mbilucaglia/ESB/Design files/usb_pcb/schematic_images/dpdt_switch.png

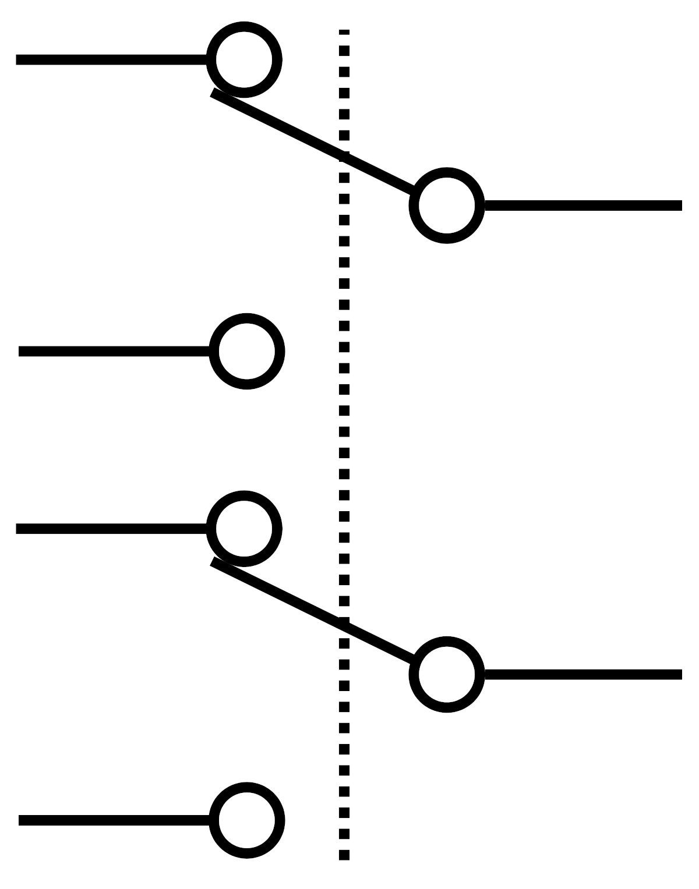
Design files/usb_pcb/schematic_images/dpdt_switch.png
