mbilucaglia/ESB/Design files/usb_pcb/schematic_images/led.png

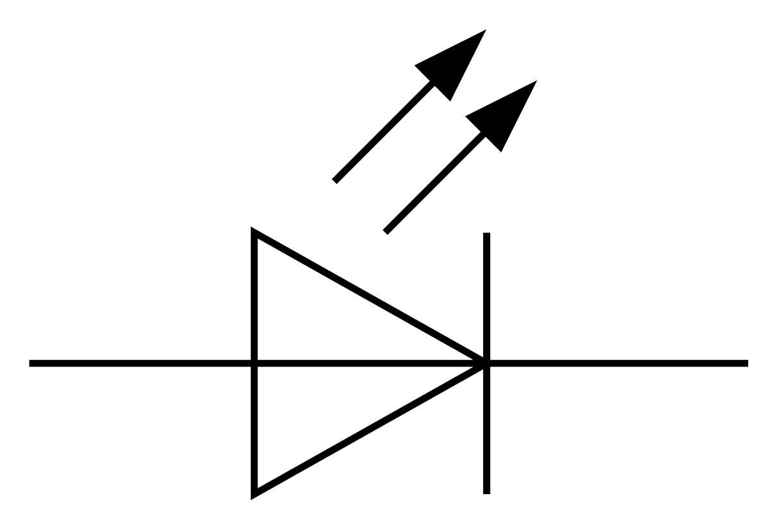
Design files/usb_pcb/schematic_images/led.png
