mbilucaglia/ESB/Design files/usb_pcb/schematic_images/spst_switch.png

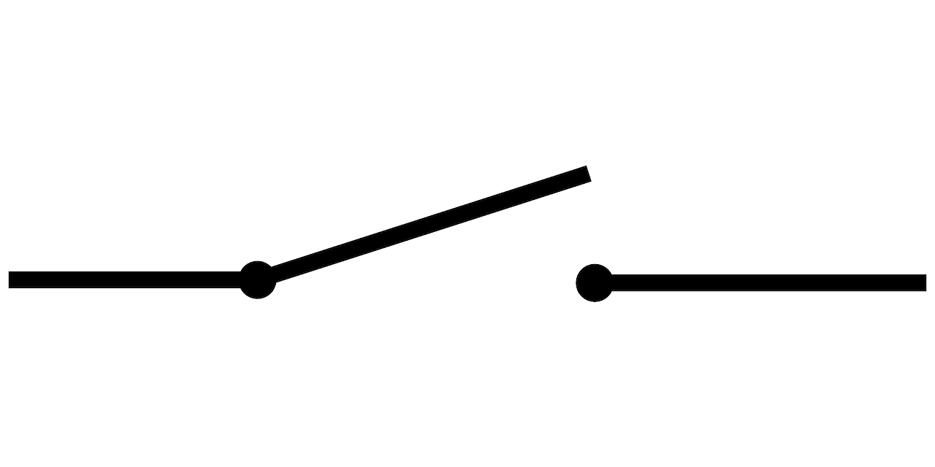
Design files/usb_pcb/schematic_images/spst_switch.png
