mbilucaglia/ESB/Bill of materials/BillOfMaterials.xlsx

Schematic ID | Designator | Component | # | Cost per unit-currency | Total cost-currency | Source of materials | Part ID (Mouser) | Total quantity | Total cost
C1 | Capacitor | 10nF 10%, 25V | 1 | 0.49 € | 0.49 € | Mouser Electronics | 80-C321C103K3G5TA | 44 | 35.828
C2, C6,C8 | Capacitor | 1uF 10%, 50V | 3 | 0.41 € | 1.22 € | Mouser Electronics | 810-FG14X7R1H105KRT6
C3 | Capacitor | 1nF 10%, 25V | 1 | 0.37 € | 0.37 € | Mouser Electronics | 80-C320C102K3G5TA
C4, C5, C7 | Capacitor | 100nF 10%, 25V | 3 | 0.25 € | 0.76 € | Mouser Electronics | 810-FA18X8R1E10400
D1 | Diode | 1N4007 | 1 | 0.16 € | 0.16 € | Mouser Electronics | 625-1N4007-E3/54
R1 | Resistor | R680 1% | 1 | 0.15 € | 0.15 € | Mouser Electronics | 594-5053HD680R0F
R2 | Resistor | R270 1% | 1 | 0.13 € | 0.13 € | Mouser Electronics | 594-5043ED270R0F
R3, R11, R12 | Resistor | R33k 1% | 3 | 0.13 € | 0.38 € | Mouser Electronics | 594-5043ED33K00F
R4 | Resistor | R10M 1% | 1 | 0.09 € | 0.09 € | Mouser Electronics | 594-5063JD10M00FT
R5 | Resistor | R10 1% | 1 | 0.11 € | 0.11 € | Mouser Electronics | 594-5063JD10R00F
R7 | Resistor | R18k 1% | 1 | 0.13 € | 0.13 € | Mouser Electronics | 594-5043ED18K00F
R8 | Resistor | R100k 1% | 1 | 0.10 € | 0.10 € | Mouser Electronics | 594-5053HD100K0F
U1 | OPAMP | MCP6024-I/P | 1 | 1.72 € | 1.72 € | Mouser Electronics | 579-MCP6024-I/P
U2 | Timer | NE555P | 1 | 0.41 € | 0.41 € | Mouser Electronics | 595-NE555P
U3 | Optoisolator | 4N35 | 1 | 0.45 € | 0.45 € | Mouser Electronics | 78-4N35
U4 | OPAMP | MCP6021-I/P | 1 | 0.92 € | 0.92 € | Mouser Electronics | 579-MCP6021-I/P
U5 | Voltage regulator | L78L05ACZ 5V voltage regulator | 1 | 0.34 € | 1.34 € | Mouser Electronics | 511-L78L05ACZ
PX | Jumper | Male jumper 10 positions | 3 | 0.86 € | 2.59 € | Mouser Electronics | 571-1-2355045-0
n.d. | Connector | Female connector 10 positions | 3 | 1.31 € | 3.93 € | Mouser Electronics | 571-1-2314876-0
D1 | LED | Green LED | 1 | 0.33 € | 0.33 € | Mouser Electronics | 630-HLMP-3950-LM000
D2 | LED | Red LED | 1 | 0.33 € | 0.33 € | Mouser Electronics | 630-HLMP-1301
SW1 | Switch | Push-pull button | 1 | 0.99 € | 0.99 € | Mouser Electronics | 612-PS1024AL-BLK
SW2A/B | Switch | Switch DPDT | 1 | 2.39 € | 2.39 € | Mouser Electronics | 612-100-F1121
SW3 | Switch | Switch SPDT | 1 | 1.89 € | 1.89 € | Mouser Electronics | 612-100-A2311
n.d. | Protoboard | Protoboard 4*4 inch | 1 | 7.37 € | 7.37 € | Mouser Electronics | 574-8015-1
J1-J9 | Jack female connector | Jack (F) connector | 9 | 0.74 € | 6.64 € | Mouser Electronics | 806-STPX-3501-3N-1
n.d. | Connector | 9V clip connector | 1 | 0.46 € | 0.46 € | Mouser Electronics | 534-232
