mbilucaglia/ESB/Design files/usb_pcb/output_files/schematic.pdf

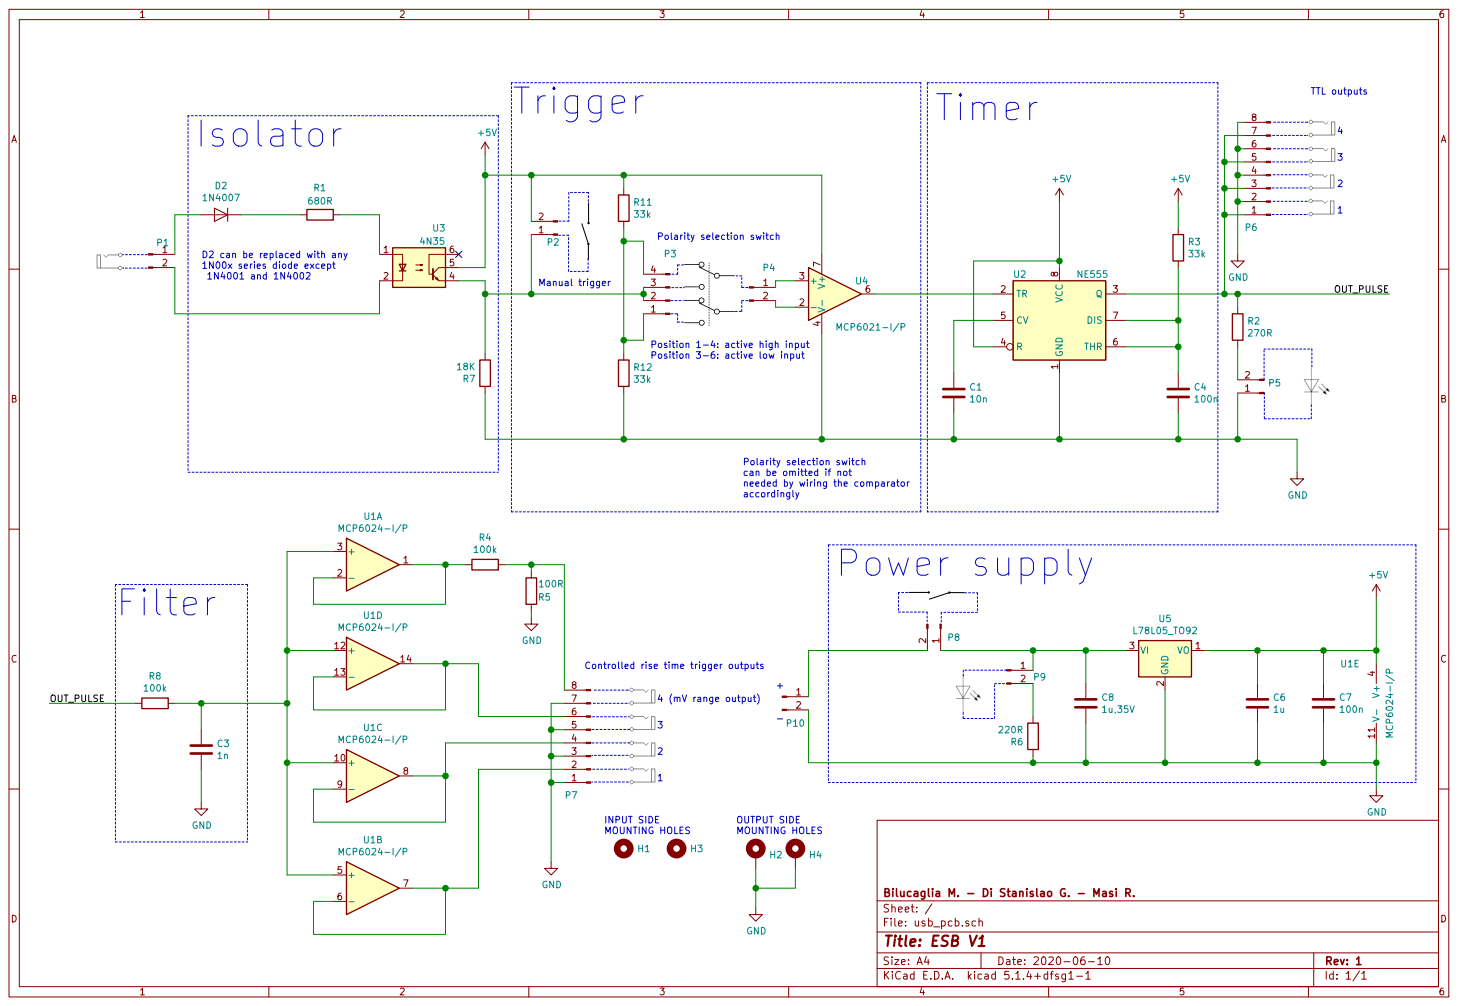
[picture p4: page 1]

D2 can be replaced with any
1N00x series diode except

Position 1-4: active high input
Position 3-6: active low input

Polarity selection switch
can be omitted if not needed by wiring the comparator

File: usb_pcb.sch Sheet: / Bilucaglia M. - Di Stanislao G. - Masi R.
