mbilucaglia/ESB/Design files/usb_pcb/output_files/layout.pdf

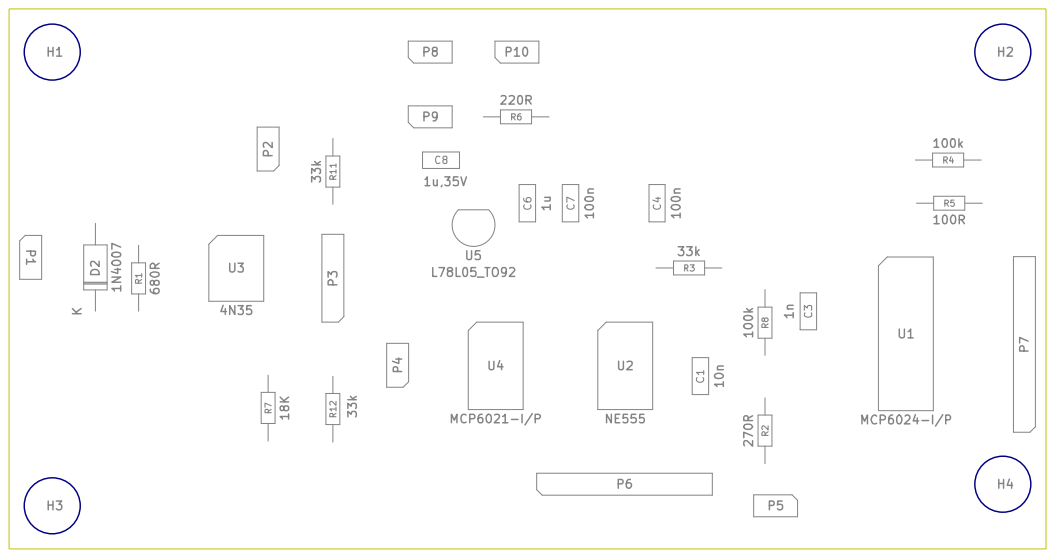
[picture p5: page 1]
