mbilucaglia/ESB/Design files/usb_pcb/usb_pcb.kicad_pcb

## KiCad design Design files/usb_pcb/usb_pcb.kicad_pcb (2021-05-02)

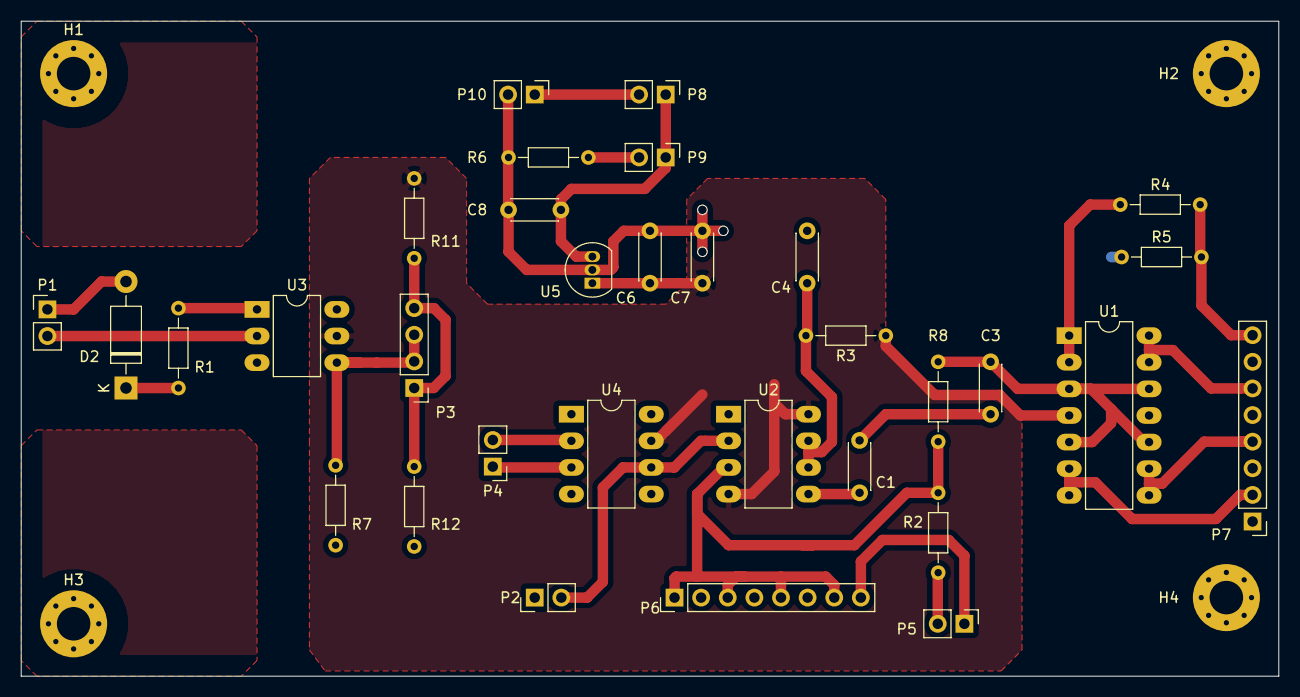
[picture p6: board usb_pcb.kicad_pcb from above]

Board: 2 copper layers, 120.0 x 62.5 mm, 36 parts (0 on the bottom side), 24 nets.

Parts:
C1: 10n; C_Disc_D4.3mm_W1.9mm_P5.00mm
C3: 1n; C_Disc_D4.3mm_W1.9mm_P5.00mm
C4, C7: 100n; C_Disc_D4.3mm_W1.9mm_P5.00mm
C6: 1u; C_Disc_D4.3mm_W1.9mm_P5.00mm
C8: 1u,35V; C_Disc_D4.3mm_W1.9mm_P5.00mm
D2: 1N4007; D_DO-41_SOD81_P10.16mm_Horizontal
H1, H3: MountingHole; MountingHole_3.2mm_M3_Pad_Via
H2, H4: MountingHole_Pad; MountingHole_3.2mm_M3_Pad_Via
P1, P2, P4, P5, P8, P9, P10: Conn_01x02_Male; PinHeader_1x02_P2.54mm_Vertical
P3: Conn_01x05_Male; PinHeader_1x04_P2.54mm_Vertical
P6, P7: Conn_01x08_Male; PinHeader_1x08_P2.54mm_Vertical
R1: 680R; R_Axial_DIN0204_L3.6mm_D1.6mm_P7.62mm_Horizontal
R2: 270R; R_Axial_DIN0204_L3.6mm_D1.6mm_P7.62mm_Horizontal
R3, R11, R12: 33k; R_Axial_DIN0204_L3.6mm_D1.6mm_P7.62mm_Horizontal
R4, R8: 100k; R_Axial_DIN0204_L3.6mm_D1.6mm_P7.62mm_Horizontal
R5: 100R; R_Axial_DIN0204_L3.6mm_D1.6mm_P7.62mm_Horizontal
R6: 220R; R_Axial_DIN0204_L3.6mm_D1.6mm_P7.62mm_Horizontal
R7: 18K; R_Axial_DIN0204_L3.6mm_D1.6mm_P7.62mm_Horizontal
U1: MCP6024-I/P; DIP-14_W7.62mm_LongPads
U2: NE555; DIP-8_W7.62mm_LongPads
U3: 4N35; DIP-6_W7.62mm_LongPads
U4: MCP6021-I/P; DIP-8_W7.62mm_LongPads
U5: L78L05_TO92; TO-92_Inline

Connections:
+5V: C6.1, C7.1, R3.1, R11.1, U1.4, U2.4, U2.8, U3.5, U4.7, U5.1
/OUT_PULSE: P6.1, P6.3, P6.5, P6.7, R2.1, R8.2, U2.3
GND: C1.2, C3.2, C4.2, C6.2, C7.2, C8.2, H2.1, H4.1, P2.1, P5.1, P6.2, P6.4, P6.6, P6.8, P7.1, P7.3, P7.5, P7.7, P10.2, R5.1, R6.1, R7.1, R12.2, U1.11, U2.1, U4.4, U5.2
unnamed: C1.1, U2.5
unnamed: C3.1, R8.1, U1.3, U1.5, U1.10, U1.12
unnamed: C4.1, R3.2, U2.6, U2.7
unnamed: C8.1, P8.1, P9.1, U5.3
unnamed: D2.1, R1.1
unnamed: D2.2, P1.1
unnamed: P1.2, U3.2
unnamed: P2.2, U2.2, U4.6
unnamed: P3.1, P3.4, R11.2, R12.1
unnamed: P3.2, P3.3, R7.2, U3.4
unnamed: P4.1, U4.3
unnamed: P4.2, U4.2
unnamed: P5.2, R2.2
unnamed: P7.2, U1.6, U1.7
unnamed: P7.4, U1.8, U1.9
unnamed: P7.6, U1.13, U1.14
unnamed: P7.8, R4.1, R5.2
unnamed: P9.2, R6.2
unnamed: P8.2, P10.1
unnamed: R1.2, U3.1
unnamed: R4.2, U1.1, U1.2
