mbilucaglia/ESB/(commit log)

2020-06-10 - Cleaned up schematic file - Added pcb footprints to all components
    [usb_pcb.sch]
2020-06-16 Created pcb layout and output files
    [usb_pcb-B_Cu.gbr, usb_pcb-B_Mask.gbr, usb_pcb-B_Paste.gbr, usb_pcb-B_SilkS.gbr, usb_pcb-Edge_Cuts.gbr, usb_pcb-F_Cu.gbr, usb_pcb-F_Mask.gbr, usb_pcb-F_Paste.gbr]
2021-05-01 Ground and power planes modified. Manual trigger position modified to work with any polarity setting
    [usb_pcb-B_Cu.gbr, usb_pcb-B_Mask.gbr, usb_pcb-B_Paste.gbr, usb_pcb-B_SilkS.gbr, usb_pcb-Edge_Cuts.gbr, usb_pcb-F_Cu.gbr, usb_pcb-F_Mask.gbr, usb_pcb-F_Paste.gbr]
2021-05-02 Minor modifications for first production run, gerber updated
    [usb_pcb-B_Cu.gbr, usb_pcb-B_Mask.gbr, usb_pcb-B_Paste.gbr, usb_pcb-B_SilkS.gbr, usb_pcb-Edge_Cuts.gbr, usb_pcb-F_Cu.gbr, usb_pcb-F_Mask.gbr, usb_pcb-F_Paste.gbr]
